IW2FAG-11/moxon-frame-generator/(list of files, cad)

Other CAD files:
moxon-frame_v3.scad
moxon-frame_v4.scad
