IW2FAG-11/moxon-frame-generator/(commit log)

2025-09-17 Upgrading
    Added some new implementation.
    Version 5 add a full wire radom to protect against weather and a parameter to resze due to elongment effect of radom.
    [moxon-frame_v3.scad, moxon-frame_v4.scad, moxon-frame_v5.scad]
2025-09-17 Improved
    Some optimization
    [moxon-frame_v5.scad]
2025-11-03 Add files via upload
    Updates to make resizing more flexible for customizing some options.
    Tested for three months at 1000m above sea level.
    [moxon-frame_v5.scad]
